Markus98/asus-x541u-headless-case/cad/out/base_nub_section.png

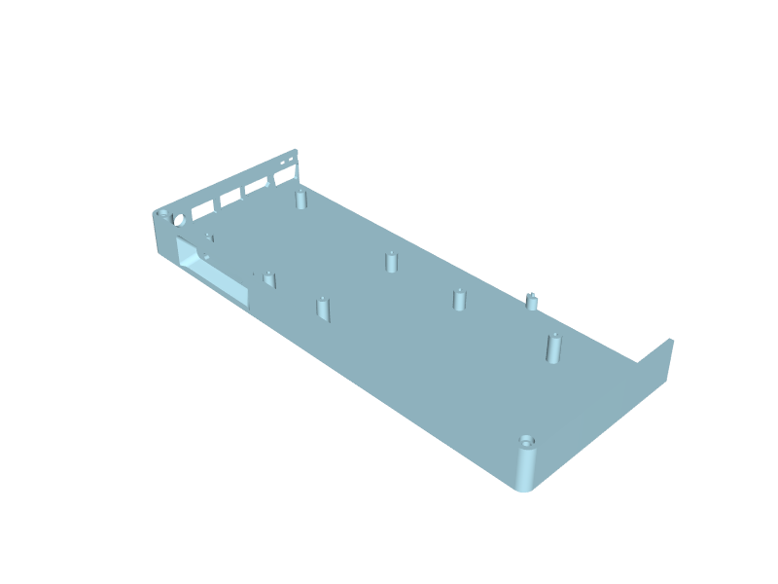
cad/out/base_nub_section.png
