Markus98/asus-x541u-headless-case/cad/out/base_top.png

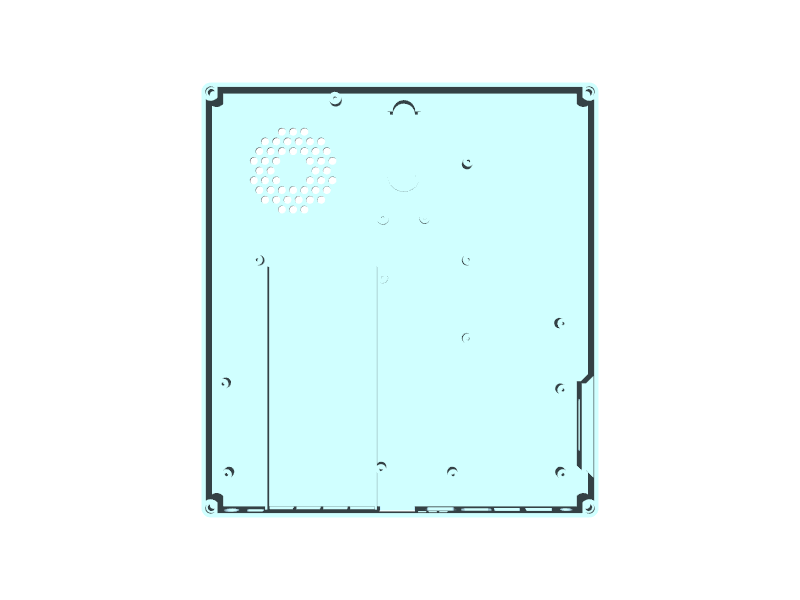
cad/out/base_top.png
