Markus98/asus-x541u-headless-case/cad/out/coil_ends.png

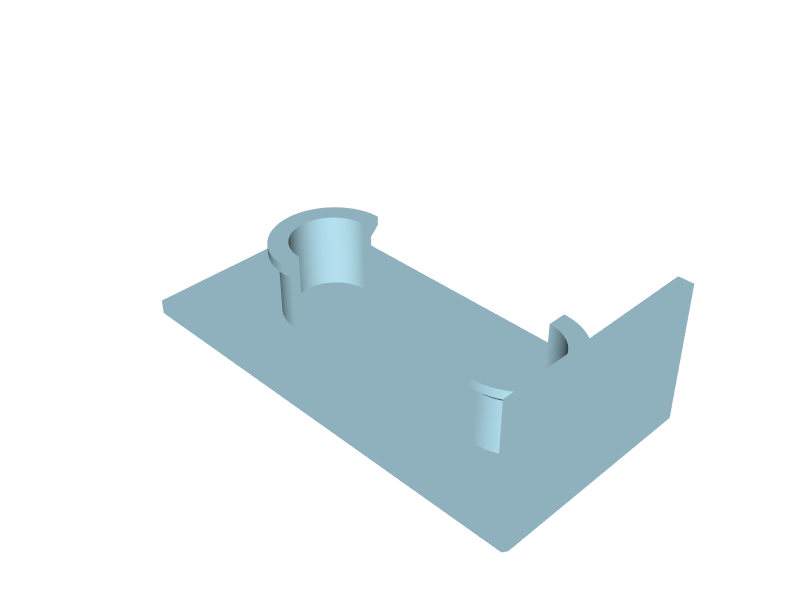
cad/out/coil_ends.png
