Markus98/asus-x541u-headless-case/cad/out/corner_base.png

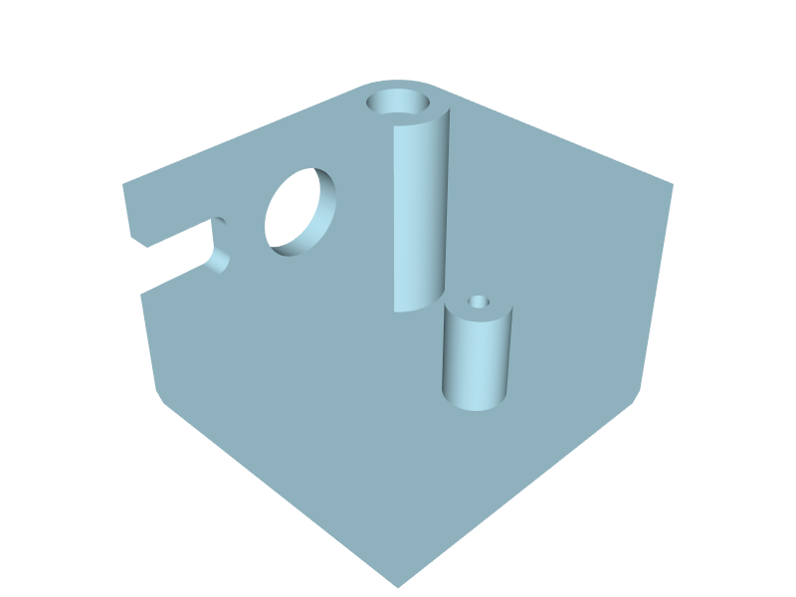
cad/out/corner_base.png
