Markus98/asus-x541u-headless-case/cad/out/corner_jig.png

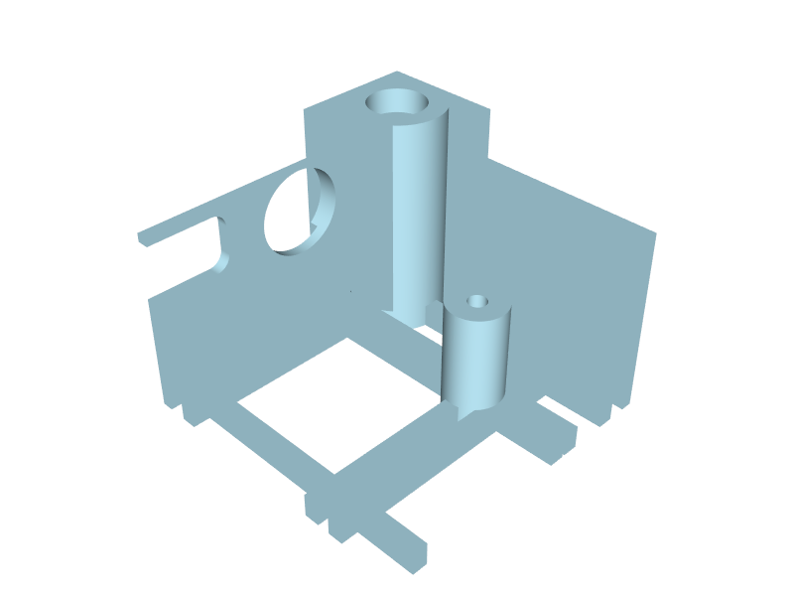
cad/out/corner_jig.png
