Markus98/asus-x541u-headless-case/cad/out/corner_jig_bottom.png

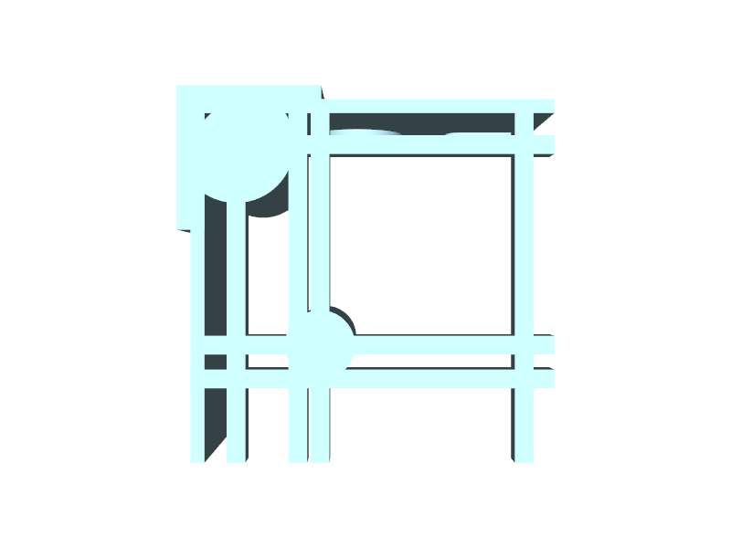
cad/out/corner_jig_bottom.png
