Markus98/asus-x541u-headless-case/cad/out/corner_lid_section.png

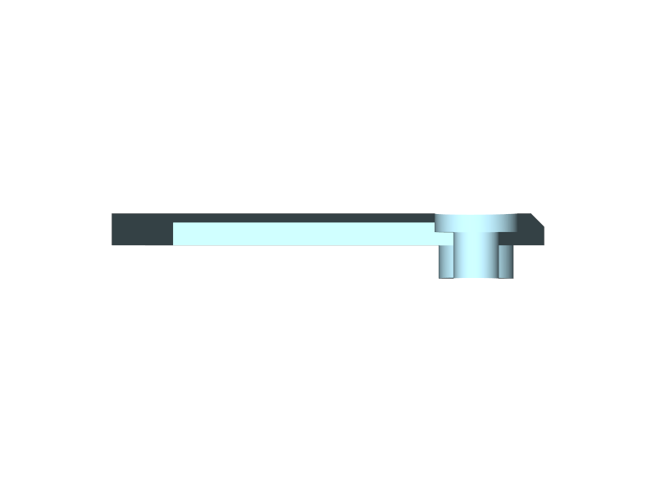
cad/out/corner_lid_section.png
