Markus98/asus-x541u-headless-case/cad/out/io_jig_iso.png

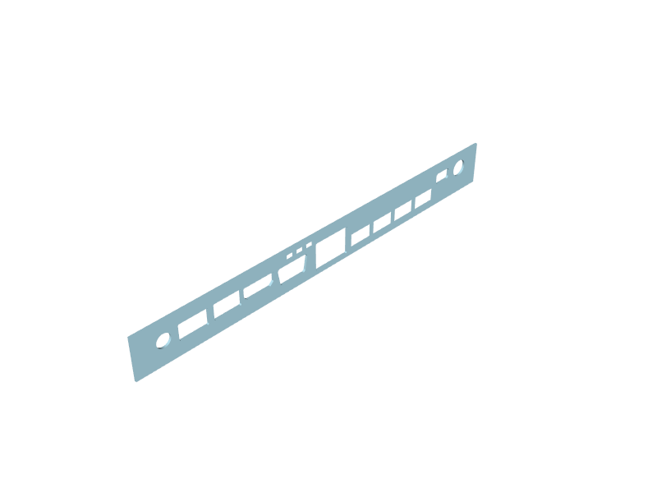
cad/out/io_jig_iso.png
