Markus98/asus-x541u-headless-case/cad/out/jig_iso.png

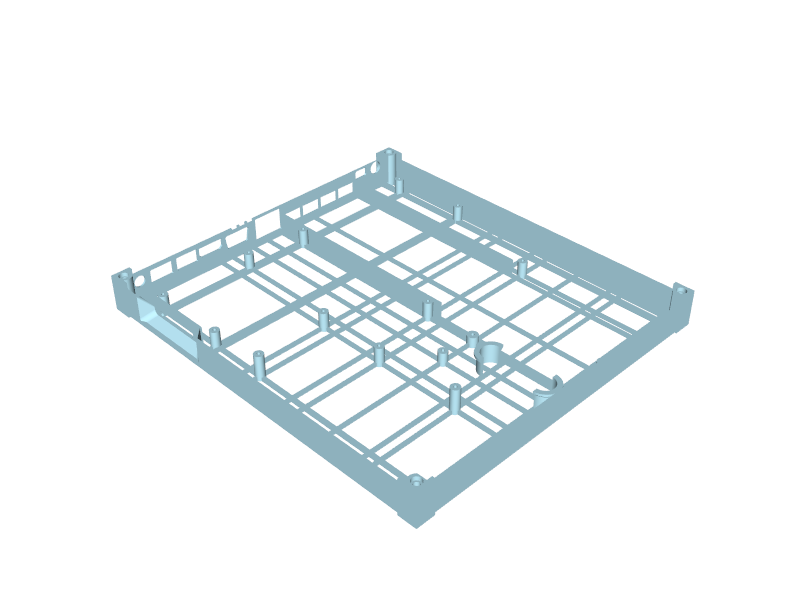
cad/out/jig_iso.png
