Markus98/asus-x541u-headless-case/cad/out/lid_led_slit_section.png

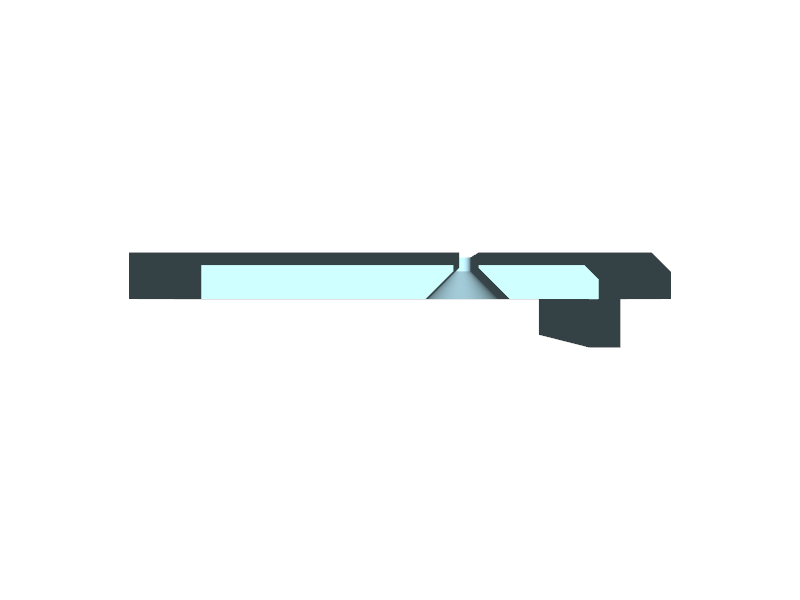
cad/out/lid_led_slit_section.png
