Markus98/asus-x541u-headless-case/cad/out/odd_spacer.png

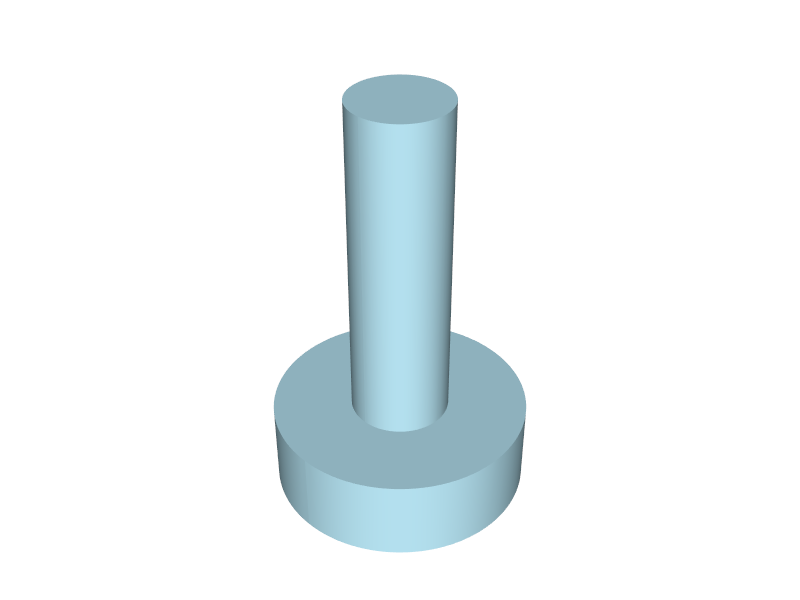
cad/out/odd_spacer.png
