Markus98/asus-x541u-headless-case/cad/out/sd_funnel_outside.png

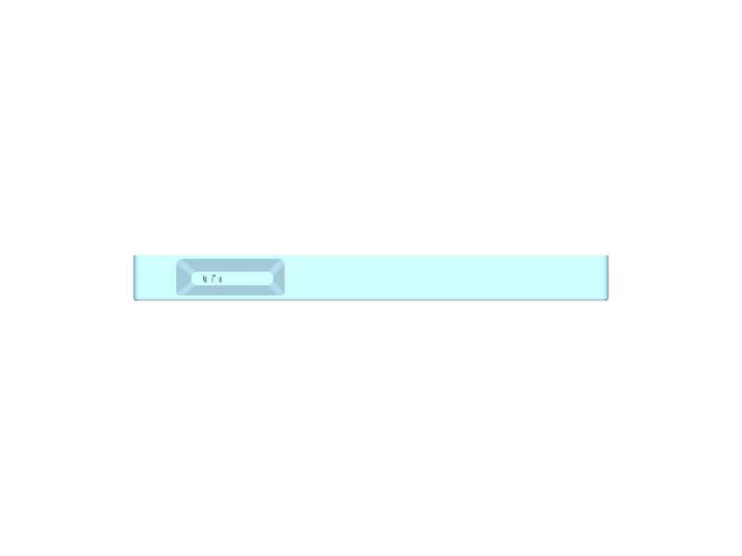
cad/out/sd_funnel_outside.png
