Markus98/asus-x541u-headless-case/cad/out/sd_funnel_section.png

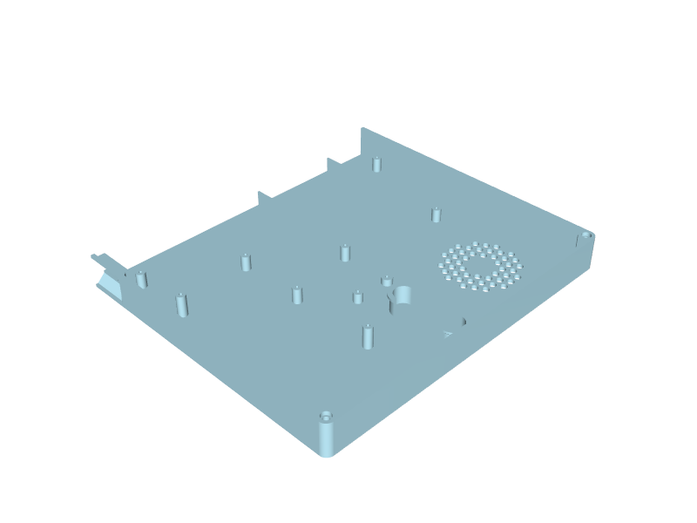
cad/out/sd_funnel_section.png
