Markus98/asus-x541u-headless-case/cad/out/stand_end.png

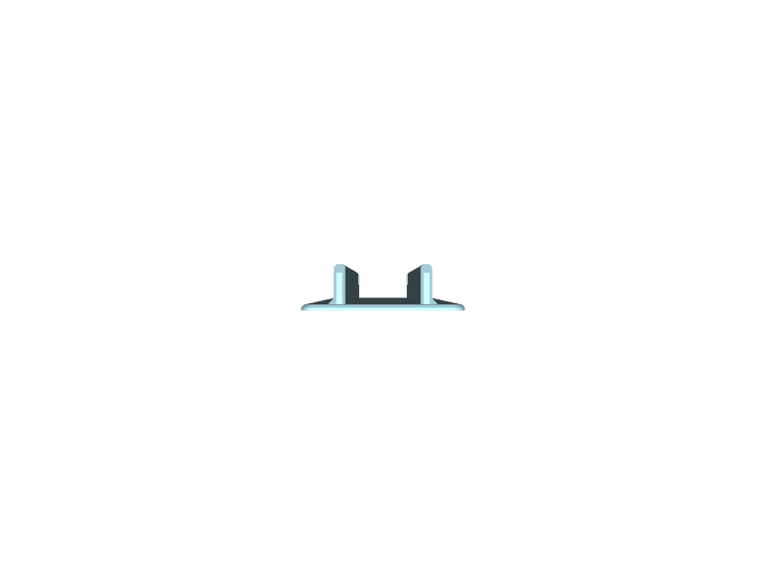
cad/out/stand_end.png
