Markus98/asus-x541u-headless-case/measurements/05-chassis-without-board_overlay.jpg

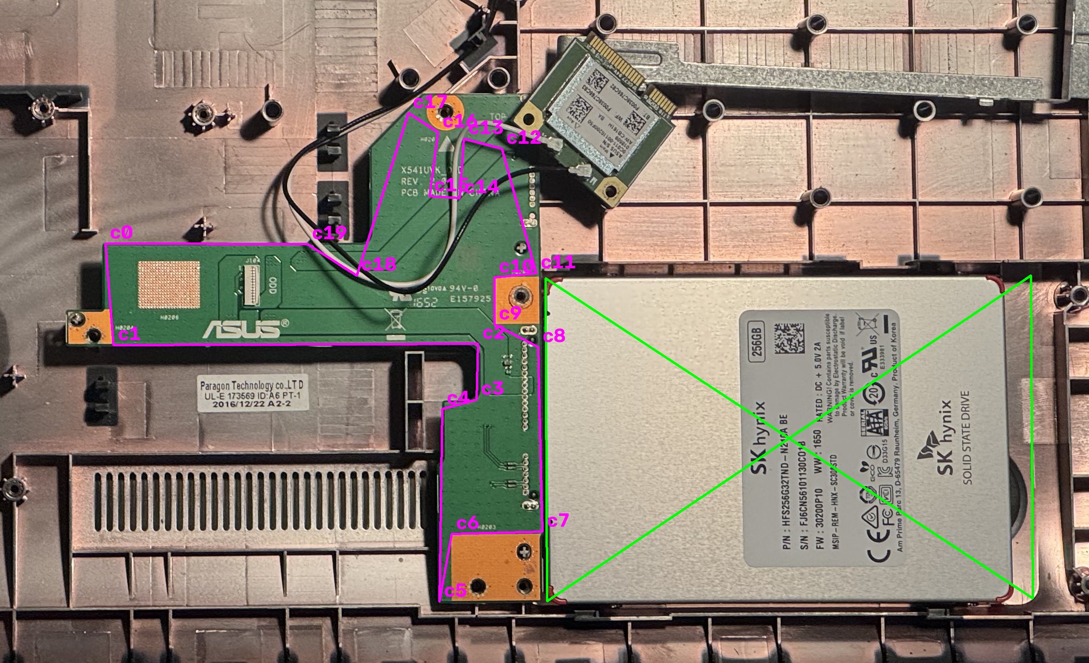
measurements/05-chassis-without-board_overlay.jpg
