Markus98/asus-x541u-headless-case/photos/01-board-in-chassis-full.jpg

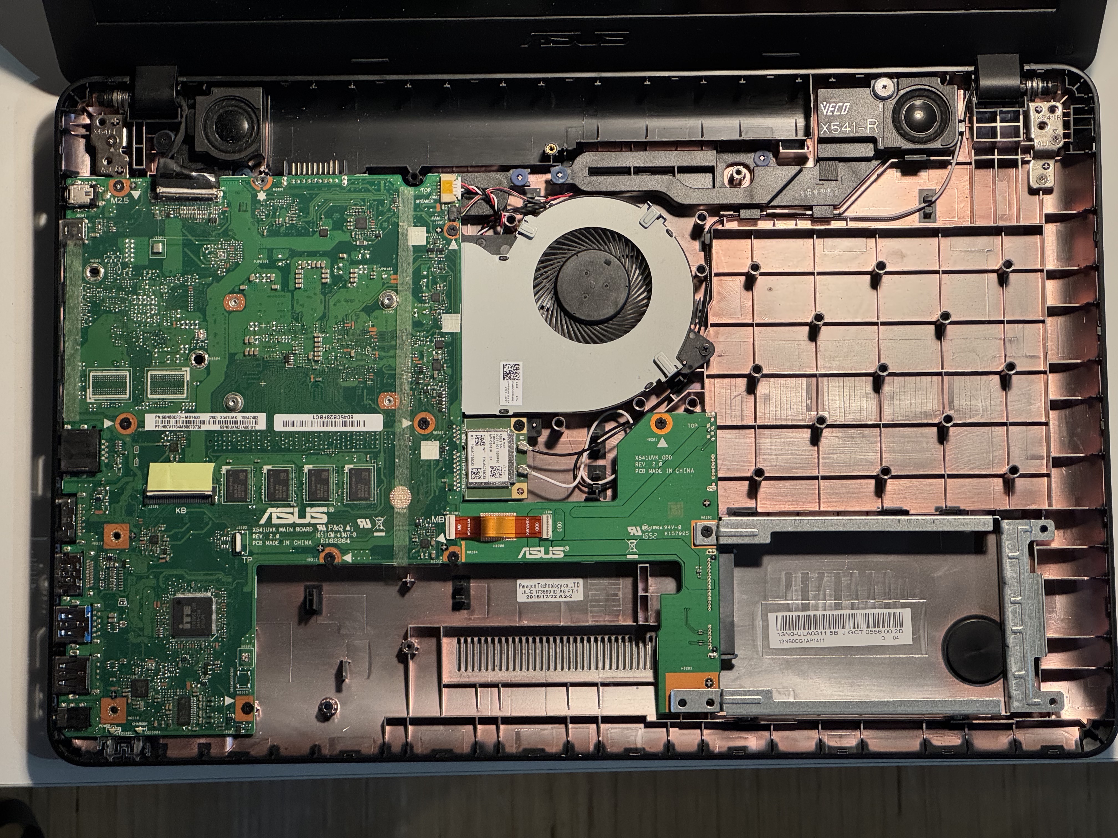
photos/01-board-in-chassis-full.jpg
