Markus98/asus-x541u-headless-case/photos/02-chassis-odd-flipped-ssd-full.jpg

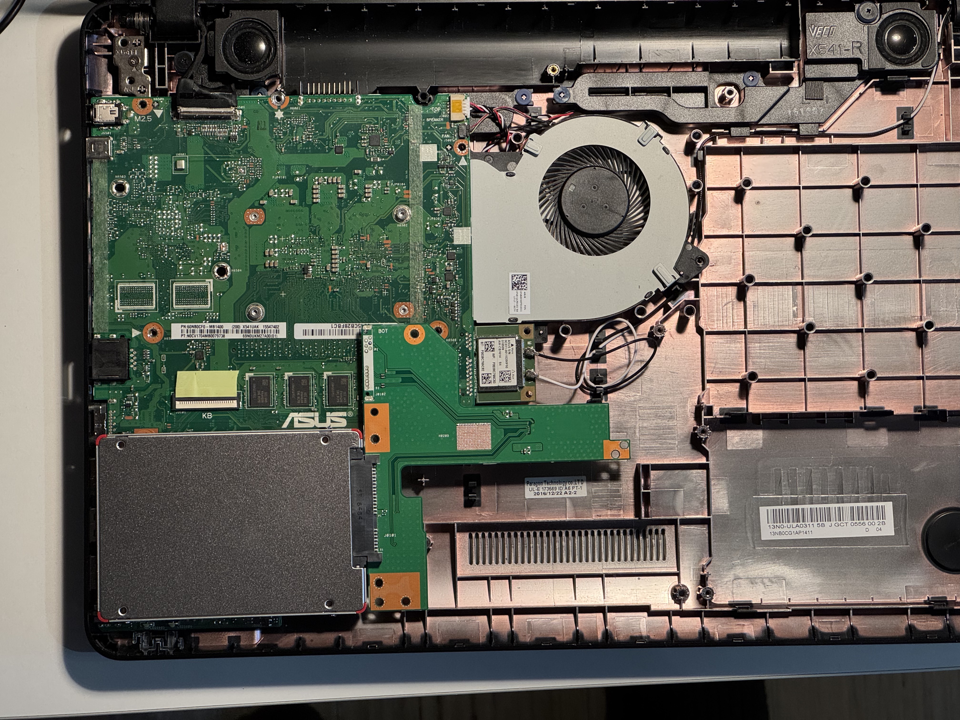
photos/02-chassis-odd-flipped-ssd-full.jpg
