Markus98/asus-x541u-headless-case/photos/03-port-edge-profile-full.jpg

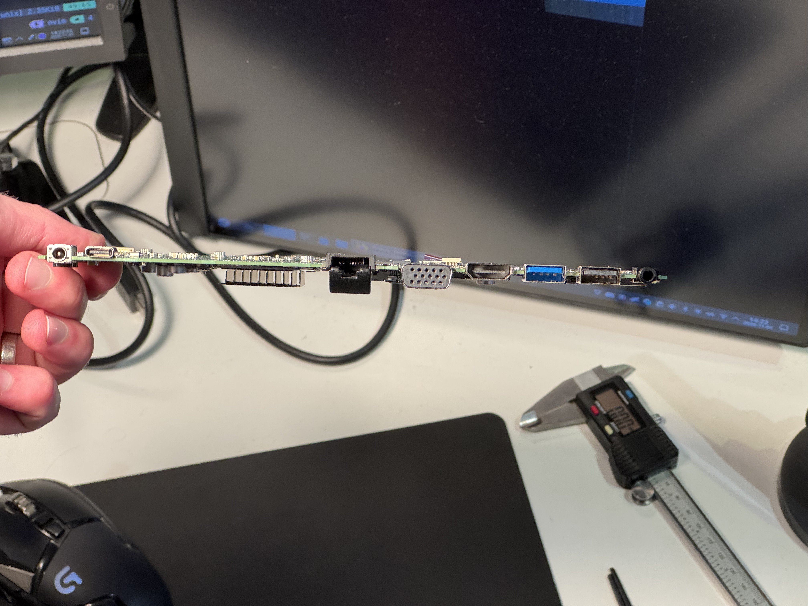
photos/03-port-edge-profile-full.jpg
