Markus98/asus-x541u-headless-case/photos/04-board-back-sd-corner-full.jpg

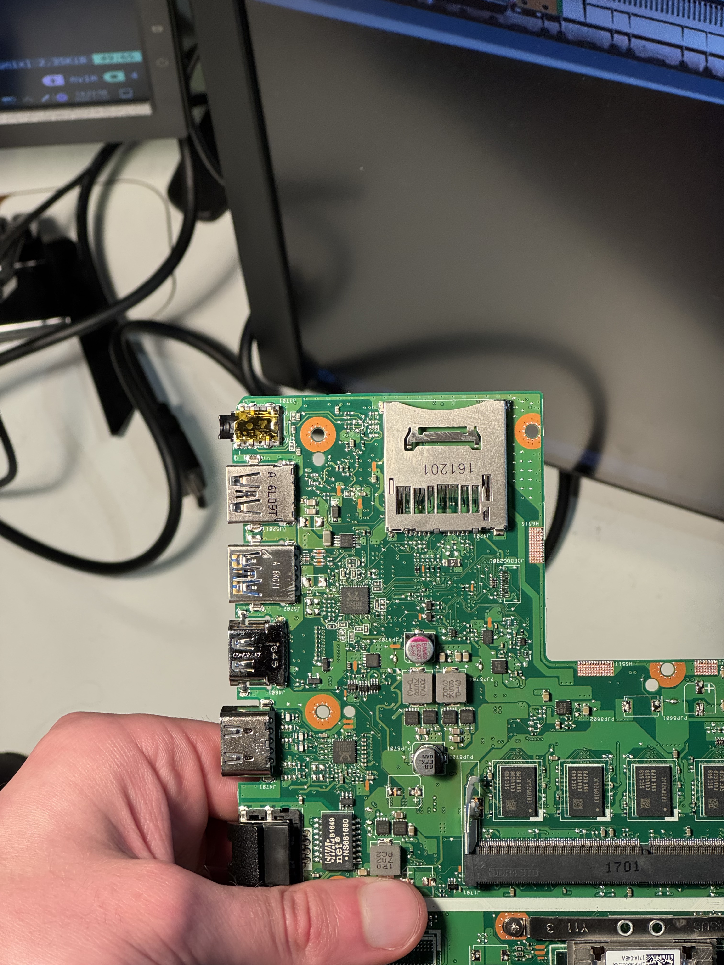
photos/04-board-back-sd-corner-full.jpg
