Markus98/asus-x541u-headless-case/photos/05-chassis-without-board-full.jpg

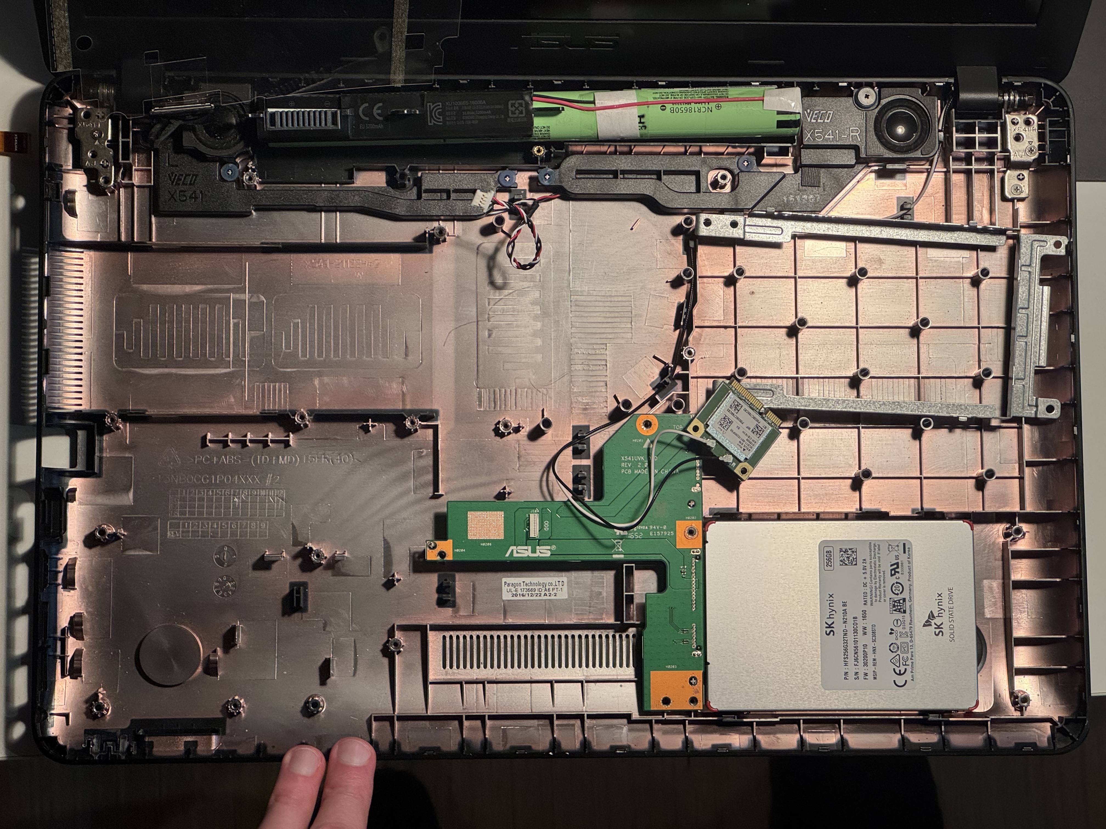
photos/05-chassis-without-board-full.jpg
