Markus98/asus-x541u-headless-case/photos/06-board-underside-full.jpg

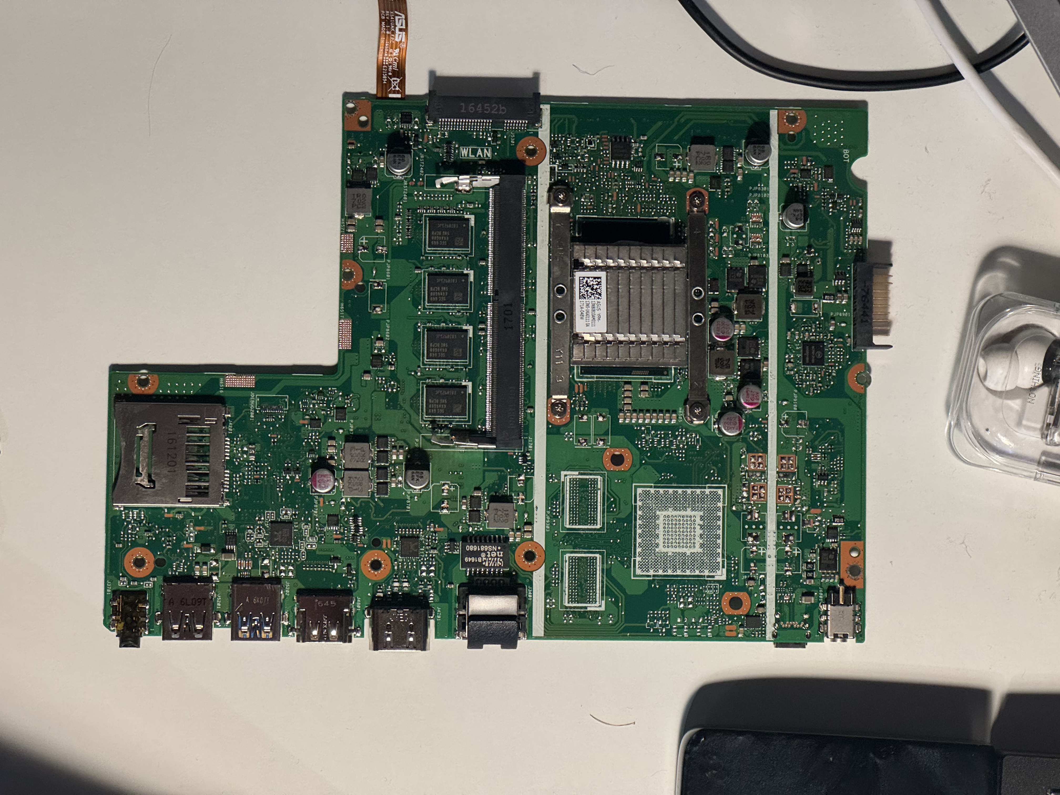
photos/06-board-underside-full.jpg
