Markus98/asus-x541u-headless-case/photos/07-odd-board-caliper-full.jpg

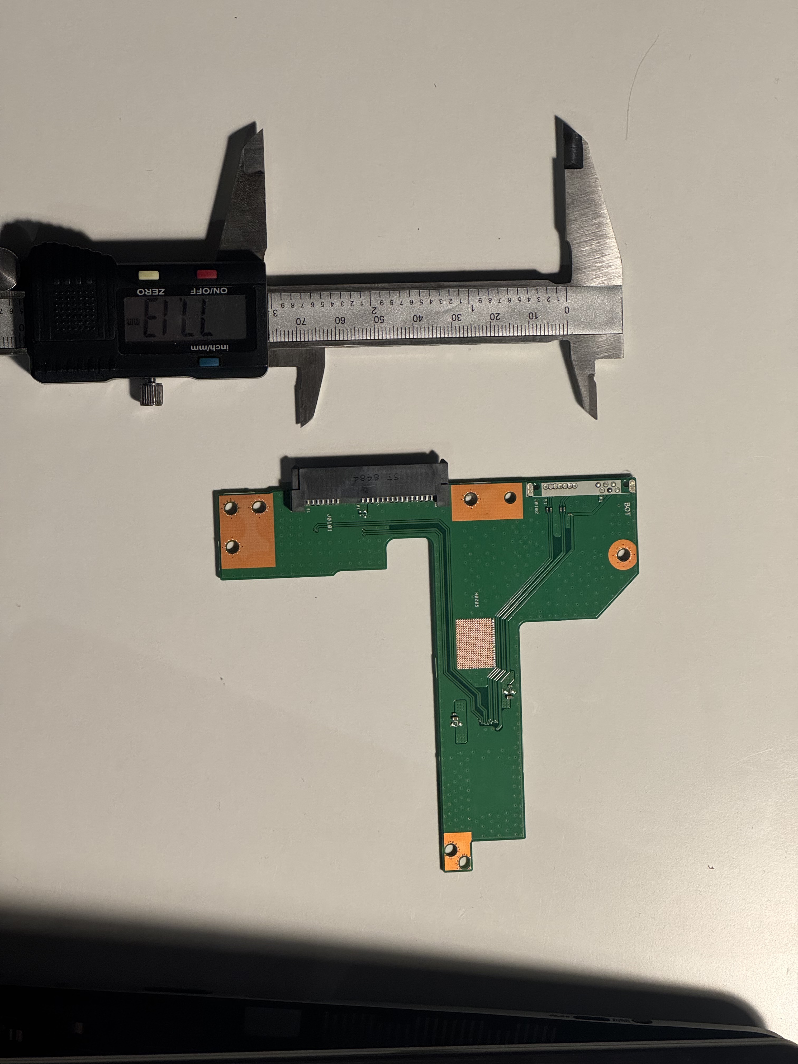
photos/07-odd-board-caliper-full.jpg
