Markus98/asus-x541u-headless-case/photos/08-fan-caliper-full.jpg

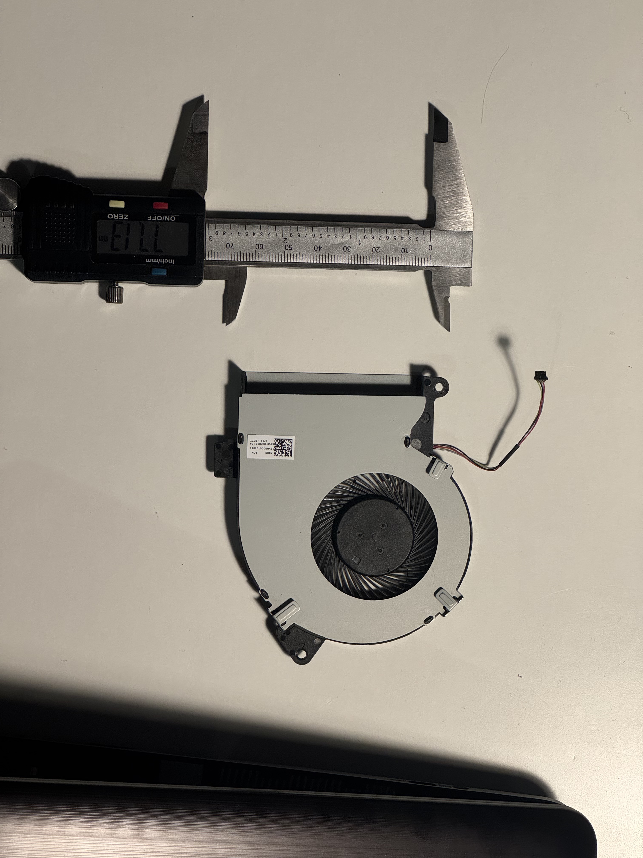
photos/08-fan-caliper-full.jpg
