Markus98/asus-x541u-headless-case/photos/09-board-in-jig-full.jpg

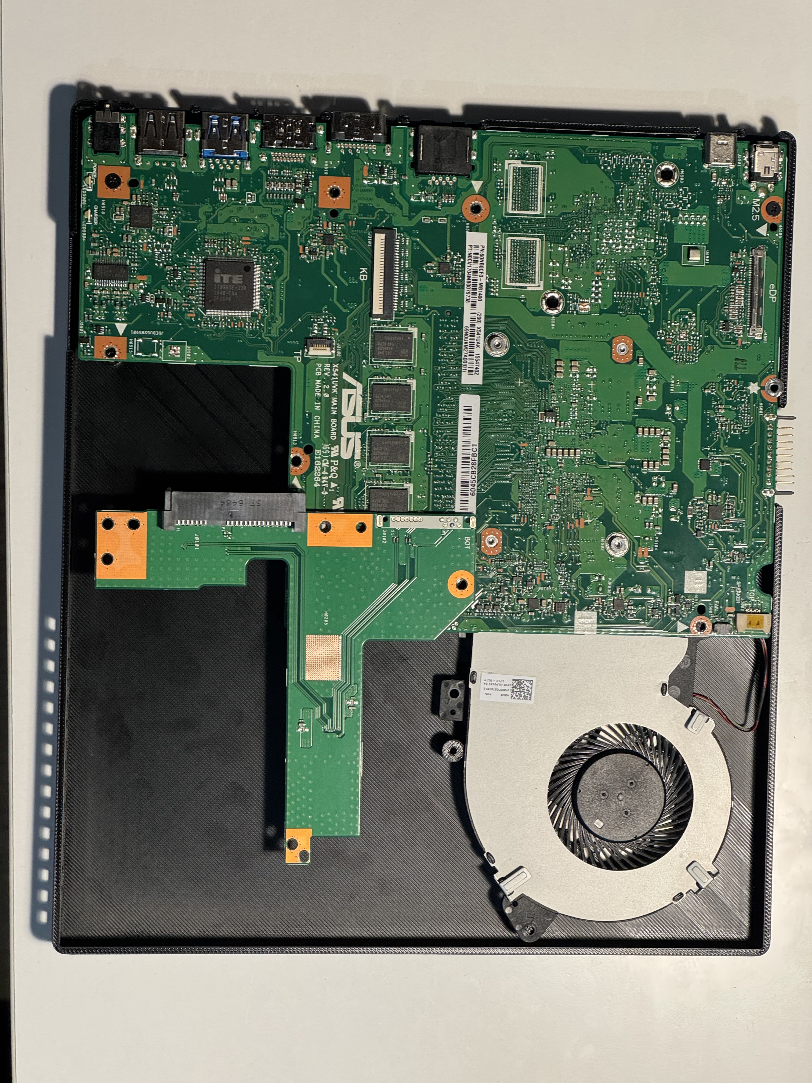
photos/09-board-in-jig-full.jpg
