Markus98/asus-x541u-headless-case/cad/out/stand.stl

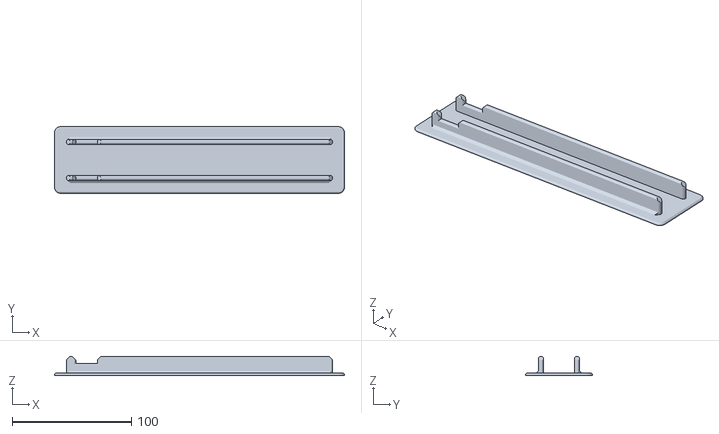
[picture p33: CAD file, 2026-11-03]
cad/out/stand.stl
243.5 x 56.0 x 16.0
