Markus98/asus-x541u-headless-case/cad/out/lid.step

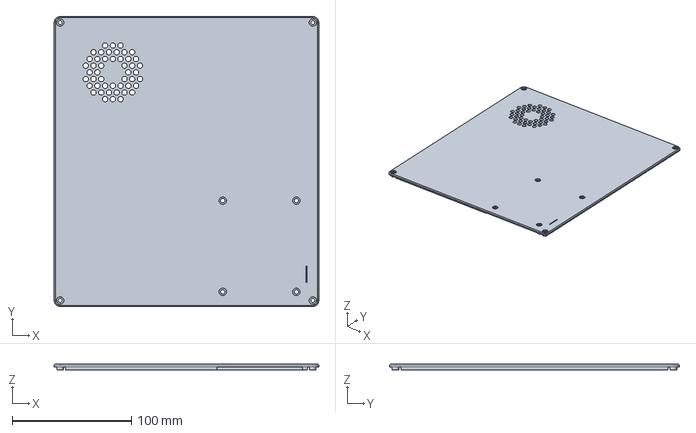
[picture p34: CAD file, 2026-11-03]
cad/out/lid.step
222.3 x 243.5 x 4.90 mm
