Markus98/asus-x541u-headless-case/cad/out/jig.stl

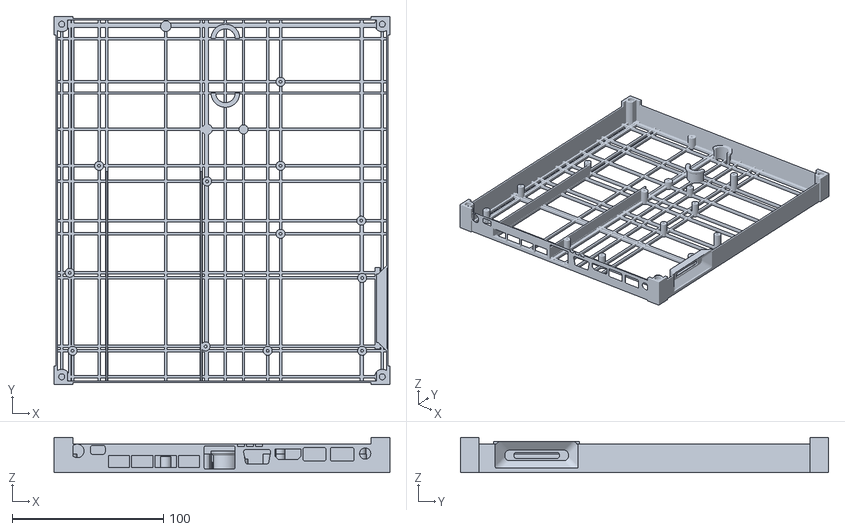
[picture p35: CAD file, 2026-11-03]
cad/out/jig.stl
222.3 x 243.5 x 23.3
