Markus98/asus-x541u-headless-case/cad/out/base.step

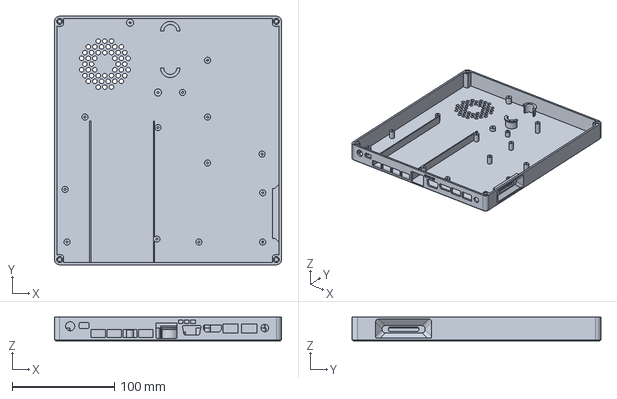
[picture p36: CAD file, 2026-11-03]
cad/out/base.step
222.3 x 243.5 x 23.3 mm
