Markus98/asus-x541u-headless-case/cad/out/io_jig.stl

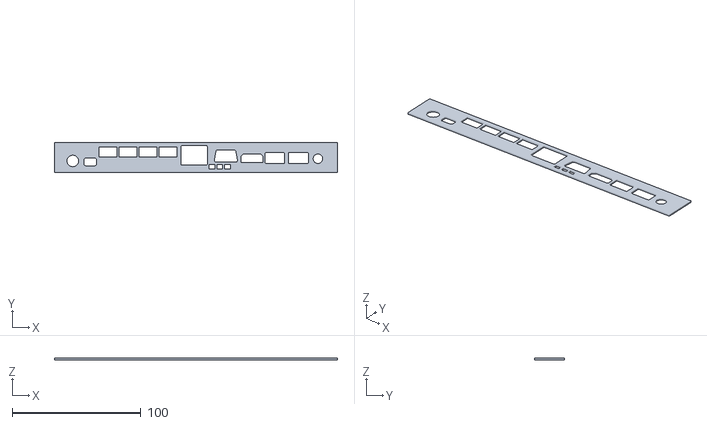
[picture p37: CAD file, 2026-11-03]
cad/out/io_jig.stl
219.9 x 23.3 x 1.20
