Markus98/asus-x541u-headless-case/cad/out/lid_jig.stl

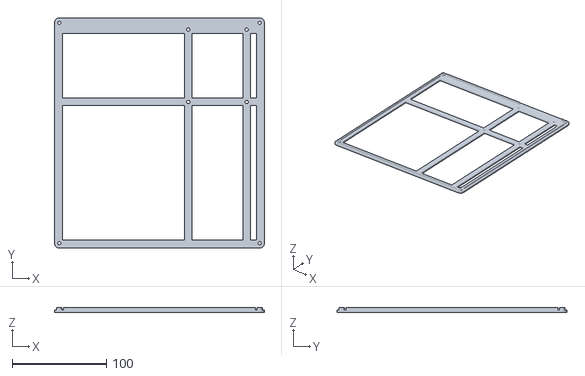
[picture p38: CAD file, 2026-11-03]
cad/out/lid_jig.stl
222.3 x 243.5 x 4.90
