Markus98/asus-x541u-headless-case/cad/out/odd_spacer.stl

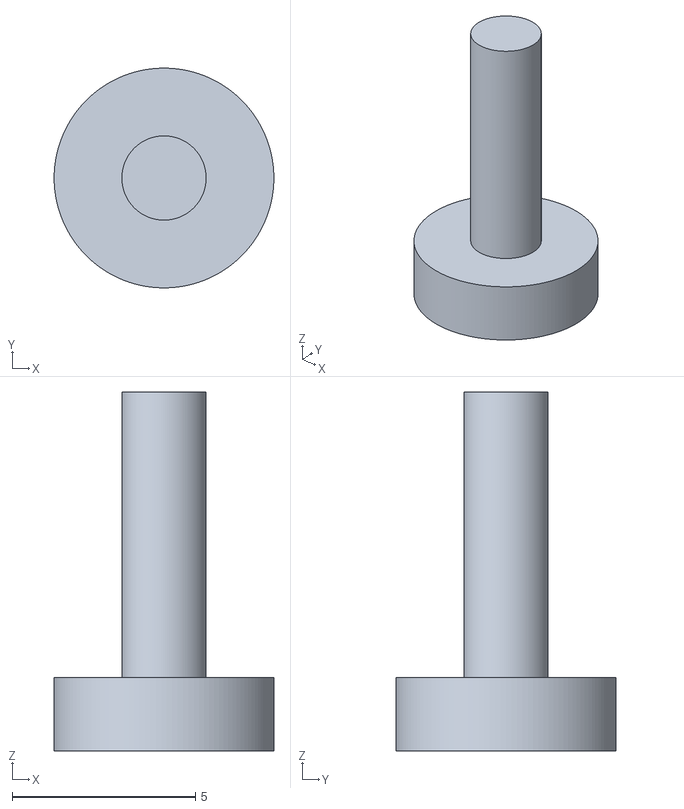
[picture p39: CAD file, 2026-11-03]
cad/out/odd_spacer.stl
6.00 x 6.00 x 9.80
