Markus98/asus-x541u-headless-case/cad/out/odd_clip.stl

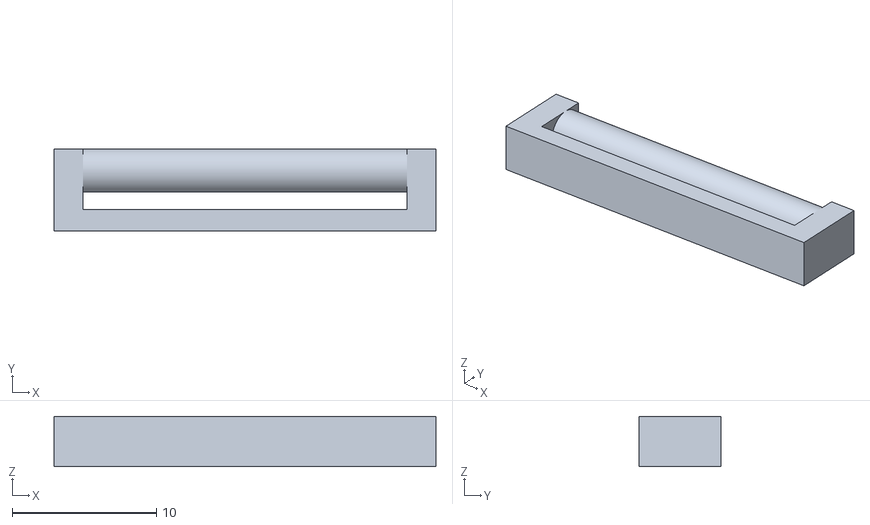
[picture p40: CAD file, 2026-11-03]
cad/out/odd_clip.stl
26.5 x 5.70 x 3.50
