Markus98/asus-x541u-headless-case/(list of files, cad)

Other CAD files:
cad/out/base.stl
cad/out/lid.stl
