Markus98/asus-x541u-headless-case/measurements/06-board-underside_green.png

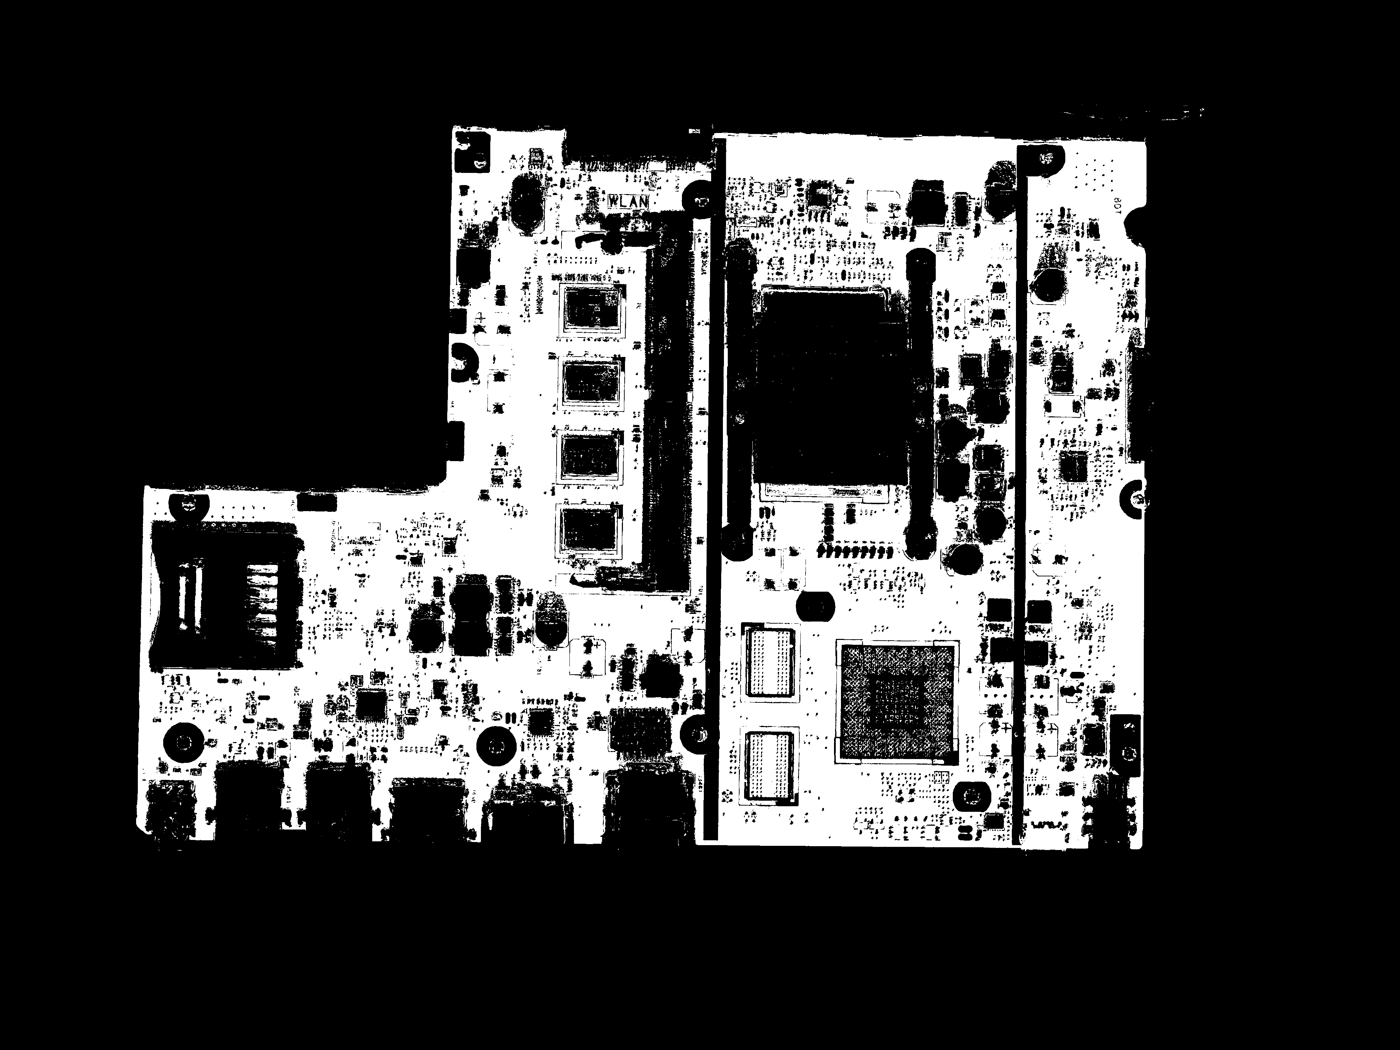
measurements/06-board-underside_green.png
