Markus98/asus-x541u-headless-case/measurements/07-odd-board-caliper_caliper.jpg

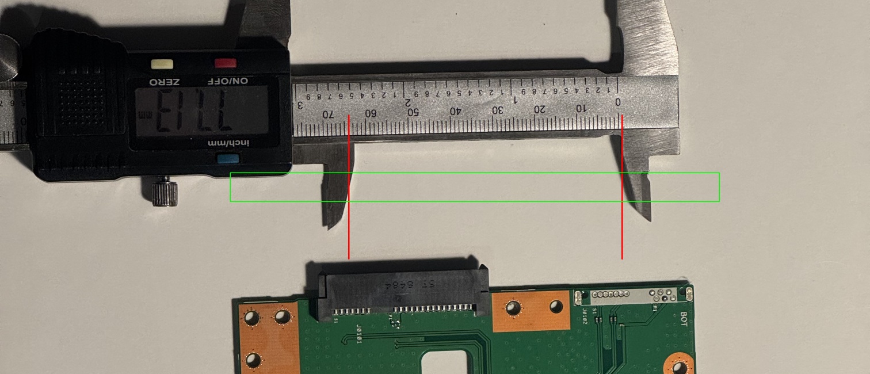
measurements/07-odd-board-caliper_caliper.jpg
