Markus98/asus-x541u-headless-case/measurements/fan_overlay.jpg

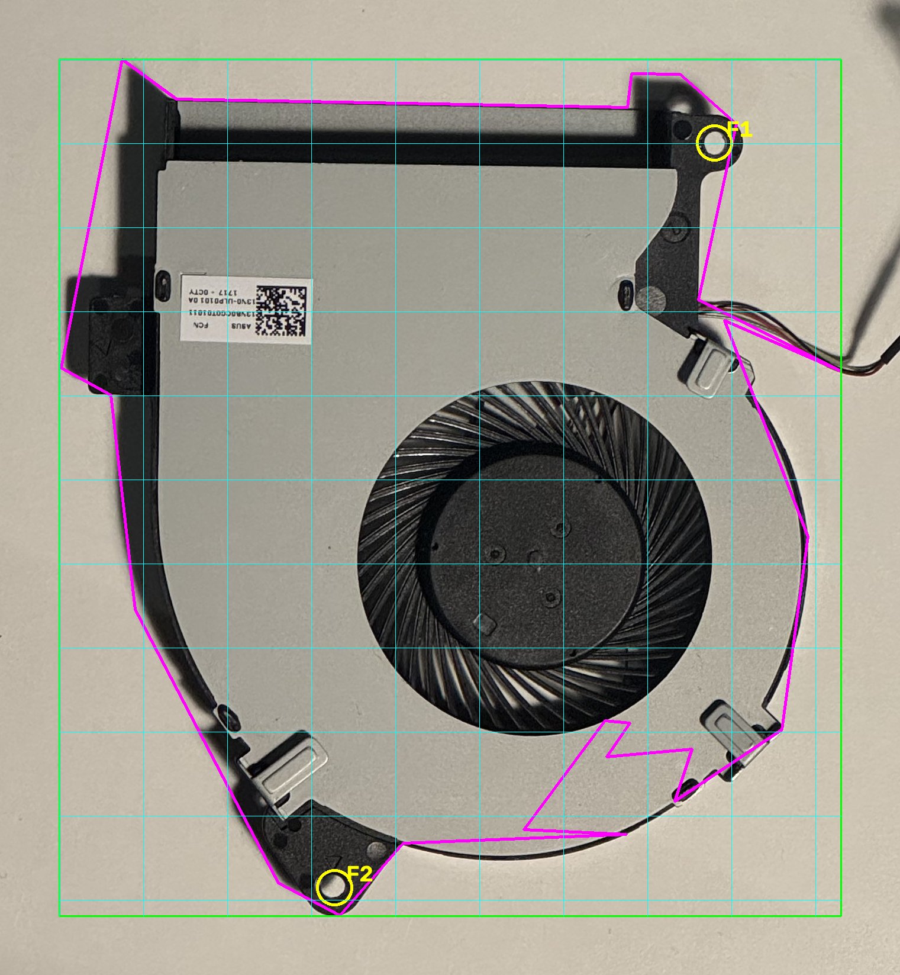
measurements/fan_overlay.jpg
