Markus98/asus-x541u-headless-case/measurements/hole_map.jpg

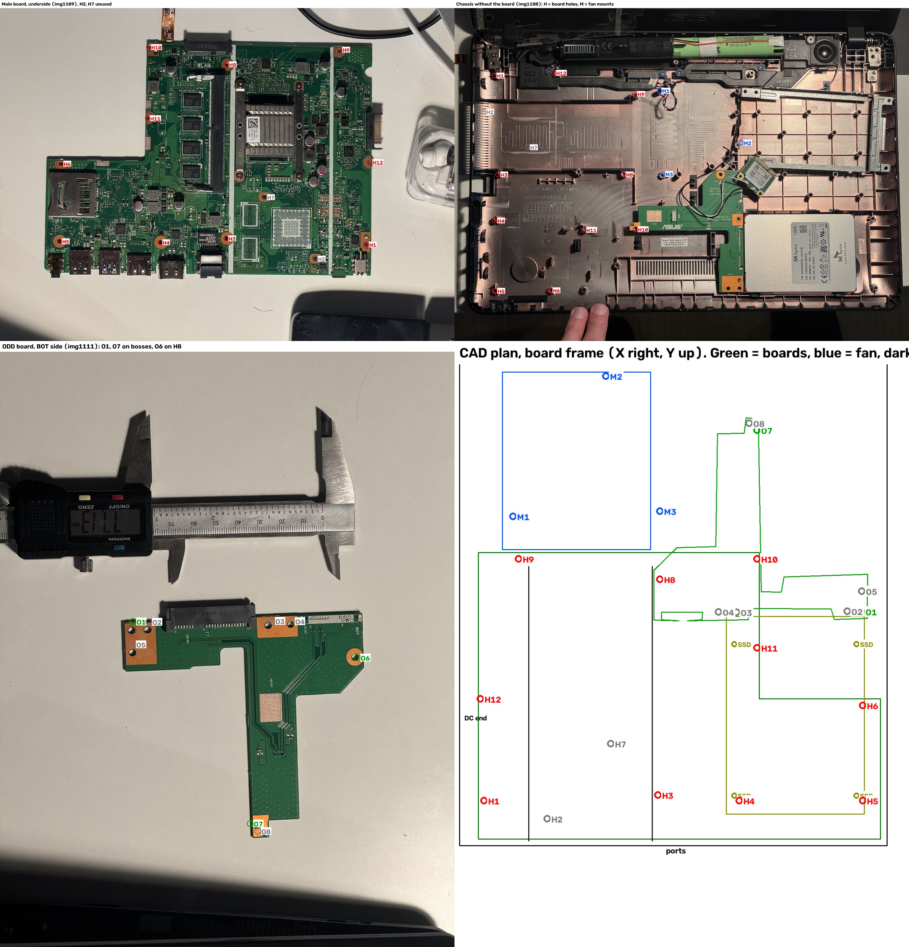
measurements/hole_map.jpg
