Markus98/asus-x541u-headless-case/measurements/odd_overlay.jpg

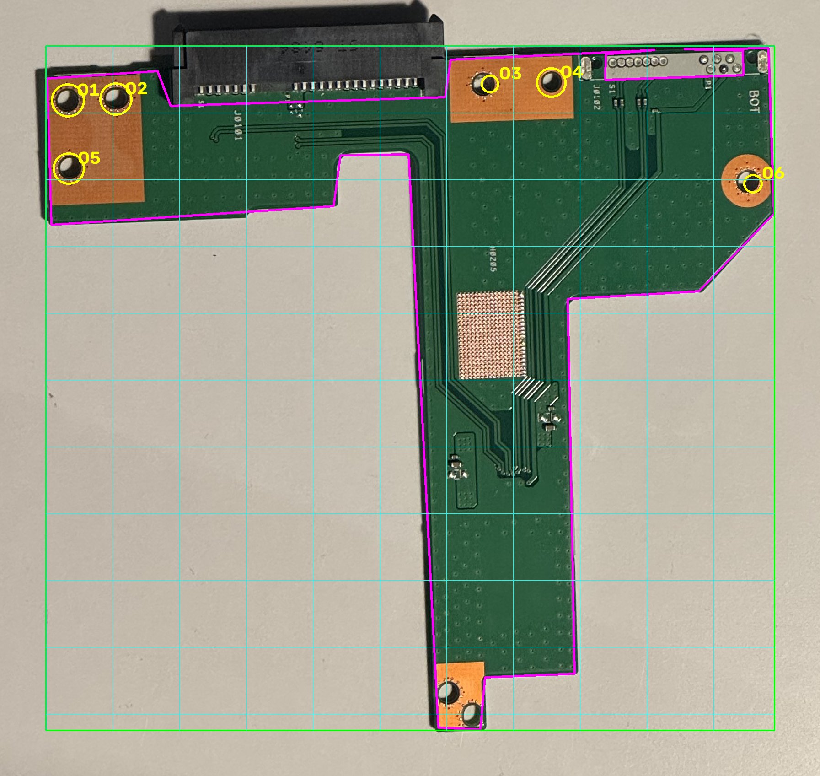
measurements/odd_overlay.jpg
