Markus98/asus-x541u-headless-case/measurements/port_profiles_overlay.jpg

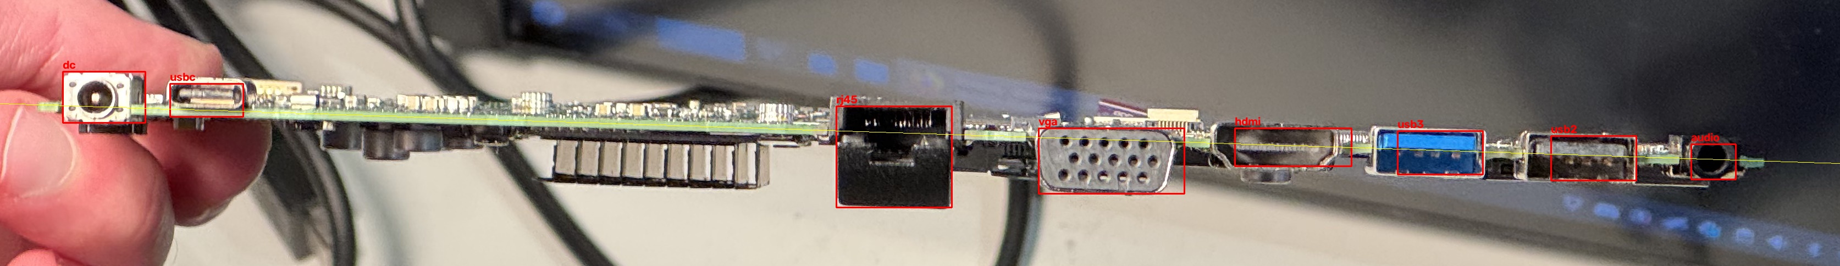
measurements/port_profiles_overlay.jpg
