Markus98/asus-x541u-headless-case/measurements/ssd_overlay.jpg

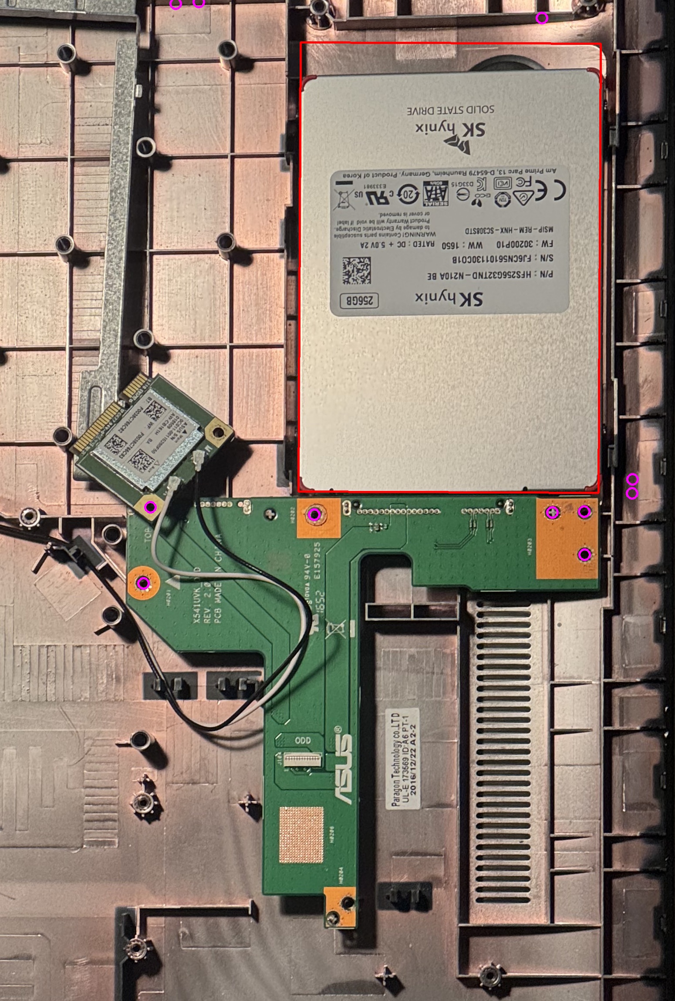
measurements/ssd_overlay.jpg
