Markus98/asus-x541u-headless-case/(commit log)

2026-11-02 Add headless case design for the ASUS X541UVK board
    Base, lid, fit jigs and spacer modeled in build123d (cad/base.py) with the
    board, fan, ODD board, SSD and port measurements computed from the photos
    by the scripts in tools/ and corrected from the printed jigs. DESIGN.md is
    the living spec. This is the state of the first full base print candidate.
    Camera originals (HEIC) are excluded because they carry location metadata;
    the JPEG conversions have no EXIF.
    [base.step, base.stl, io_jig.stl, jig.stl, lid.step, lid.stl, lid_jig.stl, spacer.stl]
2026-11-03 Rework the SD funnel, tighten pilots, move the SSD, add the ODD cable clip
    Lid v2 showed the SSD holes 0.5 off in both axes. The 2.1 mm M2.5 pilots
    printed loose at 0.2 mm layers, so they drop to the thread's minor diameter.
    The SD funnel's flat ceiling sagged as a 6 mm bridge and the opening was too
    small to pinch the card, so it is now a solid block with 45 degree flares on
    all sides and a 54 x 18 mm outer opening. The ODD ribbon needs a fold guard
    on the board's pointy end, modeled in two depths to try.
    [base.step, base.stl, jig.stl, lid.step, lid.stl, lid_jig.stl, odd_clip_1.5.stl, odd_clip_2.stl]
2026-11-03 Move the SSD to the port edge, fix the lid corners, add the ODD nub spacer
    The cable clip leaves the ODD ribbon too short for the old SSD position,
    so the SSD and ODD move 9.6 mm toward the port edge (ssd_wall_gap). The
    lid lip is omitted over the SSD and the through-standoff at H8/O6 becomes
    a 2 mm spacer with a nub reaching the lid.
    The intake row keeps only the three port-edge slots the SSD does not
    cover; the audio-end wall stays solid because the case stands on it.
    The lid corners failed to print because the chamfer at the bed removed
    the ring around the corner screw recess. The corner posts grow to 10 mm
    so the ring is 1.15 mm at the first layer with the chamfer kept.
    [base.step, base.stl, io_jig.stl, jig.stl, lid.step, lid.stl, lid_jig.stl, odd_spacer.stl]
2026-11-03 Flatten the corner posts at the board edge
    The 10 mm posts reached 0.7 and 1.2 mm past the board edge at the two
    port-edge corners, so the board sat on them in base v8. Each post is now
    cut flat at 0.5 mm from the board's X extent, the same gap the board has
    at the port edge, and the audio-end gap grows to 7.0 so both port-edge
    posts keep a 1.8 mm wall round the insert hole. The lid's corner ring
    depends only on the fillet centre, so the lid corners stay as in v4.
    [base.step, base.stl, io_jig.stl, jig.stl, lid.step, lid.stl, lid_jig.stl]
2026-11-03 Add a stand for standing the case on either end
    A slotted bar the case drops into on its DC or audio end wall with the
    ports to the back. Flipping the case between its ends puts the lid on
    the other side of the slot, so both walls get the same notches: the
    walls stop short of the ends because the lid's corner screw heads stick
    out, and drop to 8 mm over the LED slit so the LEDs stay visible when
    the case stands on the audio end. The 14 mm walls stay under the SSD
    screw heads.
    [stand.stl]
2026-11-03 Slim the stand to a flat plate with rails
    The solid 18 mm bar used three times the filament it needed and its
    wings were too tall to put anything on. The stand is now a 2 mm plate
    with two 4 mm rails round the slot, so books can lie on the plate
    beside the case. Rail height and notches are unchanged.
    [stand.stl]
2026-11-03 Chamfer the stand rails
    Every rail edge above the plate gets the same 1 mm chamfer as the plate
    edge: the slot lead-in, the outer top edge, the rail ends and the LED
    step. The concave step corners are left sharp.
    [stand.stl]
2026-11-03 Bigger chamfers on the stand's side profile
    The rail ends and the LED step risers get 3 mm chamfers so the side
    silhouette slopes instead of ending square. The long edges keep 1 mm.
    Three is the most that fits on the 7.9 mm rail piece between the end
    gap and the LED step.
    [stand.stl]
2026-11-03 Gusset the stand rails where they meet the plate
    A 2 mm 45 degree chamfer along the outside foot of each rail, on the
    concave edge against the plate, so the rails do not hinge at the layer
    line where they leave the plate. The slot side stays square so the
    case still sits flat on the plate.
    [stand.stl]
2026-11-04 Re-render every view from the current geometry
    Most renders dated from the first commit, before the SSD move, the
    flattened posts, the new SD funnel and the stand. All views are
    regenerated from the current model; the port close-ups and the
    duplicate lid corner view are dropped.
2026-11-04 Add a README
    A short front page for the repo: what the case is, renders, the parts to
    print with their orientations, how the files are regenerated, and a
    pointer to DESIGN.md for the full spec.
2026-11-04 Give the photos descriptive numbered names
    The camera numbers said nothing about what each photo shows. Each file
    is now numbered in shooting order and named for its content, the
    derived measurement overlays follow, and every reference in the spec,
    the tools and the measurement notes points at the new names. The
    ignored HEIC originals are renamed on disk to match.
2026-11-04 Show the stand render from the lid side
    The README picture of the case in its stand showed the floor grille;
    from the lid side the screw heads, the LED slit and the stand's LED
    notch are visible.
2026-11-04 Keep only the 2 mm ODD cable clip
    Both depths were printed and the 2 mm one is in use, so the 1.5 mm
    variant goes: single clip_ext value, one odd_clip.stl, spec and README
    updated.
    [odd_clip.stl, odd_clip_1.5.stl]
2026-11-06 Keep the camera originals in their own ignored directory
    The HEIC files carry location metadata. They now live in originals/,
    ignored as a whole, instead of beside the committed JPEGs in photos/,
    so nothing in a tracked directory can leak them.
